FOXHOTFIELD/Task3_YawPID_STM32F103C8/docs/tuning/drive_pulse300_2s.csv

t_s | target_deg | yaw_deg
3.7383 | -135.307 | 72.593
3.7383 | -135.307 | 72.577
3.7384 | -135.307 | 72.025
3.7384 | -135.307 | 71.085
3.7384 | -135.307 | 70.214
3.7384 | -135.307 | 69.104
3.7384 | -135.307 | 67.849
3.7384 | -135.307 | 66.563
3.7384 | -135.307 | 65.266
3.7384 | -135.307 | 64.167
3.7384 | -135.307 | 63.066
3.7384 | -135.307 | 61.726
3.7384 | -135.307 | 60.278
3.7384 | -135.307 | 58.985
3.7384 | -135.307 | 57.627
3.7384 | -135.307 | 56.229
3.7384 | -135.307 | 54.916
3.7384 | -135.307 | 53.760
3.7384 | -135.307 | 52.487
3.7384 | -135.307 | 51.037
3.7384 | -135.307 | 49.668
3.7384 | -135.307 | 48.425
3.7384 | -135.307 | 47.100
3.7384 | -135.307 | 45.792
3.7384 | -135.307 | 44.555
3.7384 | -135.307 | 43.479
3.7384 | -135.307 | 42.160
3.7384 | -135.307 | 40.780
3.7384 | -135.307 | 39.487
3.7384 | -135.307 | 38.288
3.7384 | -135.307 | 37.017
3.7384 | -135.307 | 35.746
3.7384 | -135.307 | 34.578
3.7384 | -135.307 | 33.544
3.7384 | -135.307 | 32.387
3.7384 | -135.307 | 31.054
3.7384 | -135.307 | 29.805
3.7384 | -135.307 | 28.612
3.7384 | -135.307 | 27.424
3.7385 | -135.307 | 26.187
3.7385 | -135.307 | 25.018
3.7385 | -135.307 | 23.957
3.7385 | -135.307 | 23.024
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
