FOXHOTFIELD/Task3_YawPID_STM32F103C8/docs/tuning/hands_hold.csv

t_s | target_deg | yaw_deg | rate_dps
0.0120 | 0.000 | 0.570 | -0.10
0.0199 | 0.000 | 0.570 | 0.07
0.0316 | 0.000 | 0.570 | -0.06
0.0415 | 0.000 | 0.570 | 0.02
0.0513 | 0.000 | 0.569 | 0.02
0.0608 | 0.000 | 0.569 | -0.06
0.0709 | 0.000 | 0.570 | 0.02
0.0801 | 0.000 | 0.569 | -0.10
0.0903 | 0.000 | 0.569 | 0.04
0.1004 | 0.000 | 0.568 | -0.06
0.1106 | 0.000 | 0.568 | -0.06
0.1201 | 0.000 | 0.568 | -0.09
0.1301 | 0.000 | 0.568 | 0.01
0.1401 | 0.000 | 0.568 | 0.04
0.1501 | 0.000 | 0.568 | -0.06
0.1623 | 0.000 | 0.567 | -0.03
0.1700 | 0.000 | 0.567 | 0.01
0.1820 | 0.000 | 0.567 | -0.01
0.1919 | 0.000 | 0.567 | -0.04
0.2017 | 0.000 | 0.567 | 0.05
0.2101 | 0.000 | 0.567 | -0.12
0.2200 | 0.000 | 0.568 | 0.04
0.2316 | 0.000 | 0.567 | -0.04
0.2411 | 0.000 | 0.567 | -0.04
0.2504 | 0.000 | 0.567 | -0.01
0.2599 | 0.000 | 0.566 | 0.01
0.2720 | 0.000 | 0.566 | -0.06
0.2823 | 0.000 | 0.566 | 0.02
0.2901 | 0.000 | 0.567 | 0.07
0.3004 | 0.000 | 0.567 | 0.04
0.3102 | 0.000 | 0.566 | -0.06
0.3205 | 0.000 | 0.566 | -0.09
0.3306 | 0.000 | 0.565 | -0.13
0.3407 | 0.000 | 0.565 | 0.01
0.3504 | 0.000 | 0.565 | -0.09
0.3619 | 0.000 | 0.563 | -0.15
0.3720 | 0.000 | 0.562 | -0.10
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
