FOXHOTFIELD/Task3_YawPID_STM32F103C8/docs/tuning/hands_push.csv

t_s | target_deg | yaw_deg | rate_dps
0.0101 | 0.000 | -3.399 | -24.28
0.0199 | 0.000 | -3.641 | -24.71
0.0315 | 0.000 | -3.849 | -20.92
0.0416 | 0.000 | -4.084 | -21.94
0.0511 | 0.000 | -4.216 | -11.15
0.0613 | 0.000 | -4.308 | -9.11
0.0708 | 0.000 | -4.386 | -7.32
0.0805 | 0.000 | -4.466 | -8.75
0.0903 | 0.000 | -4.581 | -12.06
0.1000 | 0.000 | -4.646 | -4.35
0.1100 | 0.000 | -4.692 | -4.85
0.1222 | 0.000 | -4.749 | -6.63
0.1310 | 0.000 | -4.801 | -4.26
0.1404 | 0.000 | -4.851 | -5.48
0.1505 | 0.000 | -4.912 | -6.13
0.1604 | 0.000 | -4.981 | -7.33
0.1705 | 0.000 | -5.061 | -8.09
0.1803 | 0.000 | -5.139 | -7.55
0.1920 | 0.000 | -5.212 | -7.35
0.2022 | 0.000 | -5.329 | -12.68
0.2122 | 0.000 | -5.415 | -7.71
0.2201 | 0.000 | -5.501 | -9.46
0.2305 | 0.000 | -5.606 | -10.53
0.2402 | 0.000 | -5.712 | -10.79
0.2519 | 0.000 | -5.834 | -12.82
0.2621 | 0.000 | -5.963 | -12.61
0.2716 | 0.000 | -6.083 | -11.70
0.2811 | 0.000 | -6.183 | -9.47
0.2917 | 0.000 | -6.270 | -8.72
0.3007 | 0.000 | -6.359 | -8.77
0.3105 | 0.000 | -6.450 | -9.41
0.3208 | 0.000 | -6.554 | -10.75
0.3309 | 0.000 | -6.672 | -12.22
0.3409 | 0.000 | -6.804 | -13.33
0.3503 | 0.000 | -6.941 | -13.85
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
