FOXHOTFIELD/Task3_YawPID_STM32F103C8/docs/tuning/imu_p_test.csv

t_s | target_deg | yaw_deg
4.4794 | 15.000 | 11.167
4.4794 | 15.000 | 11.093
4.4794 | 15.000 | 11.020
4.4794 | 15.000 | 10.947
4.4794 | 15.000 | 10.875
4.4794 | 15.000 | 10.804
4.4794 | 15.000 | 10.731
4.4794 | 15.000 | 10.659
4.4794 | 15.000 | 10.586
4.4794 | 15.000 | 10.513
4.4794 | 15.000 | 10.439
4.4794 | 15.000 | 10.365
4.4794 | 15.000 | 10.290
4.4794 | 15.000 | 10.216
4.4794 | 15.000 | 10.142
4.4794 | 15.000 | 10.068
4.4794 | 15.000 | 9.994
4.4794 | 15.000 | 9.919
4.4794 | 15.000 | 9.844
4.4794 | 15.000 | 9.770
4.4794 | 15.000 | 9.697
4.4794 | 15.000 | 9.623
4.4794 | 15.000 | 9.548
4.4794 | 15.000 | 9.474
4.4794 | 15.000 | 9.400
4.4794 | 15.000 | 9.326
4.4795 | 15.000 | 9.252
4.4795 | 15.000 | 9.177
4.4795 | 15.000 | 9.103
4.4795 | 15.000 | 9.029
4.4795 | 15.000 | 8.955
4.4795 | 15.000 | 8.881
4.4795 | 15.000 | 8.806
4.4795 | 15.000 | 8.731
4.4795 | 15.000 | 8.657
4.4795 | 15.000 | 8.583
4.4795 | 15.000 | 8.509
4.4795 | 15.000 | 8.434
4.4795 | 15.000 | 8.359
4.4795 | 15.000 | 8.284
4.4795 | 15.000 | 8.210
4.4795 | 15.000 | 8.136
4.4795 | 15.000 | 8.061
4.4795 | 15.000 | 7.988
4.4795 | 15.000 | 7.914
4.4795 | 15.000 | 7.841
4.4795 | 15.000 | 7.767
4.4795 | 15.000 | 7.693
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
