FOXHOTFIELD/Task3_YawPID_STM32F103C8/docs/tuning/openloop_duty100.csv

t_s | target_deg | yaw_deg
4.5097 | 0.001 | 0.668
4.5097 | 0.001 | 0.668
4.5097 | 0.001 | 0.668
4.5097 | 0.001 | 0.668
4.5097 | 0.001 | 0.668
4.5097 | 0.001 | 0.668
4.5097 | 0.001 | 0.668
4.5097 | 0.001 | 0.668
4.5097 | 0.001 | 0.668
4.5097 | 0.001 | 0.668
4.5097 | 0.001 | 0.668
4.5097 | 0.001 | 0.668
4.5097 | 0.001 | 0.668
4.5097 | 0.001 | 0.668
4.5097 | 0.001 | 0.668
4.5097 | 0.001 | 0.668
4.5097 | 0.001 | 0.668
4.5097 | 0.001 | 0.668
4.5097 | 0.001 | 0.668
4.5097 | 0.001 | 0.668
4.5097 | 0.001 | 0.668
4.5097 | 0.001 | 0.668
4.5097 | 0.001 | 0.668
4.5097 | 0.001 | 0.668
4.5097 | 0.001 | 0.668
4.5098 | 0.001 | 0.668
4.5098 | 0.001 | 0.668
4.5098 | 0.001 | 0.668
4.5098 | 0.001 | 0.668
4.5098 | 0.001 | 0.668
4.5098 | 0.001 | 0.668
4.5098 | 0.001 | 0.668
4.5098 | 0.001 | 0.668
4.5098 | 0.001 | 0.668
4.5098 | 0.001 | 0.668
4.5098 | 0.001 | 0.668
4.5098 | 0.001 | 0.668
4.5098 | 0.001 | 0.668
4.5098 | 0.001 | 0.668
4.5098 | 0.001 | 0.668
4.5098 | 0.001 | 0.668
4.5098 | 0.001 | 0.668
4.5098 | 0.001 | 0.668
4.5098 | 0.001 | 0.668
4.5098 | 0.001 | 0.668
4.5098 | 0.001 | 0.668
4.5098 | 0.001 | 0.668
4.5098 | 0.001 | 0.668
4.5098 | 0.001 | 0.668
4.5098 | 0.001 | 0.668
4.5098 | 0.001 | 0.668
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
