FOXHOTFIELD/Task3_YawPID_STM32F103C8/docs/tuning/openloop_duty200.csv

t_s | target_deg | yaw_deg
4.3097 | -0.004 | 0.000
4.3097 | -0.004 | 0.000
4.3097 | -0.004 | 0.000
4.3097 | -0.004 | 0.000
4.3097 | -0.004 | 0.000
4.3097 | -0.004 | 0.000
4.3097 | -0.004 | 0.000
4.3097 | -0.004 | 0.000
4.3097 | -0.004 | 0.000
4.3097 | -0.004 | 0.000
4.3097 | -0.004 | 0.000
4.3097 | -0.004 | 0.000
4.3097 | -0.004 | 0.000
4.3097 | -0.004 | 0.000
4.3097 | -0.004 | 0.000
4.3097 | -0.004 | 0.000
4.3097 | -0.004 | 0.000
4.3097 | -0.004 | 0.000
4.3097 | -0.004 | 0.000
4.3097 | -0.004 | 0.000
4.3097 | -0.004 | 0.000
4.3097 | -0.004 | 0.000
4.3097 | -0.004 | 0.000
4.3097 | -0.004 | 0.000
4.3097 | -0.004 | 0.000
4.3097 | -0.004 | 0.000
4.3097 | -0.004 | 0.000
4.3097 | -0.004 | 0.000
4.3097 | -0.004 | 0.000
4.3097 | -0.004 | 0.000
4.3097 | -0.004 | 0.000
4.3097 | -0.004 | 0.000
4.3097 | -0.004 | 0.000
4.3097 | -0.004 | 0.000
4.3097 | -0.004 | 0.000
4.3097 | -0.004 | 0.000
4.3097 | -0.004 | 0.000
4.3097 | -0.004 | 0.000
4.3097 | -0.004 | 0.000
4.3097 | -0.004 | 0.000
4.3097 | -0.004 | 0.000
4.3097 | -0.004 | 0.000
4.3097 | -0.004 | 0.000
4.3097 | -0.004 | 0.000
4.3097 | -0.004 | 0.000
4.3097 | -0.004 | 0.000
4.3097 | -0.004 | 0.000
4.3097 | -0.004 | 0.000
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
