FOXHOTFIELD/Task3_YawPID_STM32F103C8/Core/Inc/main.h

/**
 * @file    main.h
 * @brief   26级第三期考核任务 —— TB6612 电机驱动与水平转盘 Yaw 闭环控制
 * @target  STM32F103C8T6 最小系统板, HSE 8MHz, SYSCLK 72MHz
 */
#ifndef __MAIN_H
#define __MAIN_H

#ifdef __cplusplus
extern "C" {
#endif

#include "stm32f1xx_hal.h"

void Error_Handler(void);

#ifdef __cplusplus
}
#endif

#endif /* __MAIN_H */
