FOXHOTFIELD/Task3_YawPID_STM32F103C8/App/Inc/app_i2c_bus.h

/**
 * @file    app_i2c_bus.h
 * @brief   I2C 总线抽象：硬件 I2C 与软件模拟 I2C 两套实现，接口一致
 *
 * 评分点 2 要求"理解硬件 I2C 与软件模拟 I2C 的区别"，
 * 所以这里把两者做成同一套 API 的两个后端，由 board_config.h 里的
 * IMU_I2C_BACKEND_HW 编译期切换：
 *   - 硬件 I2C：由 I2C1 外设产生严格的起始/停止/ACK 时序，CPU 不参与位操作，
 *               可以挂 DMA，速率可到 400kHz 且抖动小；
 *   - 软件模拟：GPIO 开漏 + 延时函数自己翻电平，时序受中断影响会抖动，
 *               速率受 CPU 主频和延时精度限制，但引脚可任意指定、不占用外设。
 */
#ifndef APP_I2C_BUS_H
#define APP_I2C_BUS_H

#ifdef __cplusplus
extern "C" {
#endif

#include <stdint.h>
#include "stm32f1xx_hal.h"

/** @brief 初始化所选后端（软件后端会重新配置 PB6/PB7 为开漏 GPIO） */
HAL_StatusTypeDef i2c_bus_init(void);

/** @brief 写寄存器（单寄存器地址 + n 字节数据） */
HAL_StatusTypeDef i2c_bus_write(uint8_t addr7, uint8_t reg, const uint8_t *data, uint16_t len);

/** @brief 读寄存器（单寄存器地址 + n 字节数据），轮询式 */
HAL_StatusTypeDef i2c_bus_read(uint8_t addr7, uint8_t reg, uint8_t *data, uint16_t len);

/** @brief 读寄存器（DMA 方式，仅硬件后端支持；软件后端返回 HAL_ERROR） */
HAL_StatusTypeDef i2c_bus_read_dma(uint8_t addr7, uint8_t reg, uint8_t *data, uint16_t len);

/** @brief 总线卡死后的恢复：SCL 打 9 个时钟 + 发送 STOP */
void i2c_bus_recover(void);

/** @brief 后端名称，用于 INFO/日志输出 */
const char *i2c_bus_name(void);

/**
 * @brief 扫描 0x08..0x77 上应答的地址
 * @param found 输出数组
 * @param max   数组容量
 * @return 实际找到的设备数
 */
uint8_t i2c_bus_scan(uint8_t *found, uint8_t max);

#ifdef __cplusplus
}
#endif

#endif /* APP_I2C_BUS_H */
