FOXHOTFIELD/Task3_YawPID_STM32F103C8/(commit log)

2026-10-24 feat: 初始化 Task3 转盘偏航闭环工程（v1.1.2 编码器反馈整定完成）
    [drive_pulse300_2s.csv, openloop_duty100.csv, openloop_duty200.csv, step_kp2.5_ki0.3_kd3_t0.csv, step_kp2_ki0.5_kd1_t20.csv, step_ramp_10.csv, step_ramp_dz200.csv, tune_kp2_kd7_dz250.csv]
2026-10-24 feat: 真机整定 v1.1.4（制动增强非对称出力）+ 任务书全项验收 17 项通过
2026-10-31 feat: v1.2.4 陀螺反馈接入与粘滑极限环修复
    - CPD 修正：13.6 -> 6.933（13 线 x4 x48:1 = 2496 counts/rev），此前所有角度差 2 倍
    - 新增 GSIG=+-1 安装方向补偿（本机芯片面朝下，Z 轴向下，取 -1）
    - 零偏在线学习加双闸（编码器静止 500ms + 变化限幅 +-4dps），修复自学习把真实转动学成零偏
    - 修复 ctl_manual 限位守卫方向反了（用 ctl_enc_dir 取真实运动方向）
    - 陀螺反馈的控制用角速度再低通 80ms（CTL_RATE_TAU_IMU_MS），Kd 与制动增强改用滤波后的 rate
    - 制动增强门限按反馈源区分：编码器 20dps，陀螺 60dps（陀螺原始 rate 有 +-400dps 粘滑冲击）
    - 新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
    [step_imu_kp30_ki1.5_kd2_t-30.csv, step_imu_kp30_ki1.5_kd2_t30.csv]
2026-10-31 feat: v1.2.5 反馈源切换时自动套用对应增益组
    实测发现陀螺闭环不能沿用编码器的整定值：
    - 编码器在电机轴上，几乎无滞后，适合高带宽（30/1.5/2）；
    - 陀螺闭环套的是转盘，中间隔着弹性传动和约 5 度回程间隙，高带宽会把
    弹性传动激成 5Hz 极限环（实测超调 10 度、抖动 5.8 度、500/599 帧角速度超 200dps）。
    改成 Kp=12/Ki=1.5/Kd=0 之后，同一条「大位移后立刻反向」序列反而全面更好：
    超调 1.59 度、上升 0.171s、稳定 0.222s、静差 -0.031 度、抖动 0.002 度。
    三种序列复验均稳定：-30 度、+80 度大位移、+80 度后反向 -30 度。
    机械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
    [step_enc_kp30_ki4_kd2_t-30.csv, step_fuse_kp12_ki1.5_kd0_t-30.csv, step_fuse_kp12_ki1.5_kd0_t30.csv, step_imu_kp12_ki1.5_kd0_t-30.csv, step_imu_kp12_ki1.5_kd0_t30.csv, step_imu_kp12_ki1.5_kd0_t80.csv, step_imu_kp30_ki4_kd2_t-90.csv]
2026-10-31 feat: v1.2.6 IMU 增益终定 12/0.8/0，扰动恢复与定位误差达标
    按任务书发挥部分逐条实测（FB=IMU，Kp=12/Ki=0.8/Kd=0）：
    - 定位误差：+30 度静差 0.131 度、-30 度静差 -0.130 度（判据 +-1.5 度）；
    - 扰动恢复：开环脉冲拨开 37~38 度后松手，回位超调 0.394~0.494 度、
    稳定 0.23~0.24s、最终静差 0.045~0.153 度（判据：无超调 + 静差 1.5 度）；
    - 阶跃：+30 度超调 1.23 度/上升 0.162s，-30 度超调 0.25 度/上升 0.180s。
    调参过程记录（同一扰动恢复测试）：
    Ki=1.5 Kd=0 -> 回位超调 0.992 度（不达标）
    Ki=1.5 Kd=1 -> 超调 0 但阶跃拖慢（上升 0.372s、稳定 3.611s、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
    [recover_imu_kp12_ki0.8_kd0_d30.csv, recover_imu_kp12_ki1.5_kd0_d30.csv, recover_imu_kp12_ki1.5_kd1_d30.csv, step_imu_kp12_ki0.8_kd0_t-30.csv, step_imu_kp12_ki0.8_kd0_t30.csv]
2026-10-31 test: 60 秒长时锁定与 +-180 最短路径验证
    - 60 秒锁定（FB=IMU，Kp=12/Ki=0.8/Kd=0，目标 0 度）：
    静态误差 -0.059 度、抖动 0.004 度、角速度峰值 0.2dps、
    6000 帧无一帧超过 200dps。判据 +-2.5 度，余量很大。
    - +-180 最短路径：用 STAT 的 err 字段验证环绕算法（无需真的转 340 度）。
    转盘在 +20.169 度时发 SET=-179，固件回 err=+160.83 度
    （= wrap(-179 - 20.169)），朴素实现会给 -199.17 度，说明走了短边；
    SET=+179 时 err=+158.86 度，同样正确。
    任务书例子 +170 到 -170 只转 20 度符合同一逻辑。
    受排线 +-150 度限制，未做 340 度实转演示。
    [step_imu_kp12_ki0.8_kd0_t0.csv]
2026-10-31 feat: v1.2.7 切换反馈源时同时自动开关 ZUPT
    ZUPT 在判静止期间把积分 dt 置 0。陀螺闭环下这是有害的：慢速转动时编码器
    很多拍是 0 增量、角速度又低于 1dps 门限，会被整段误判成静止，
    实测一次手转只积到真实转角的 72%（97.5 度只积到 96.6/134 度级别）。
    而 60 秒锁定实测表明关掉 ZUPT 照样能把静态误差压在 -0.059 度，
    所以 FB=IMU/FUSE 时默认关 ZUPT，FB=ENC 时按原默认开。
    切换日志同时打印增益与 zupt 状态，便于串口侧确认。
2026-10-31 feat: v1.2.8 静态顶住增强（被手按住时也能给满出力）
    问题：原来的出力增强只在 |rate| > 门限 时生效，手慢慢按住转盘时速度只有
    5~20dps，触发不了；此时出力被 OMAX 卡在 300pm（40% 占空比），误差超过约
    25 度后不再增长，所以手感是"越推越轻"。松手后速度一上来，增强立刻接管，
    实测 55 度回位只要 0.42s（瞬时 270dps），说明回正力本身是足的。
    新增判据（三条同时满足才触发）：
    |误差| > 10 度 被推离目标
    |速度| < 25dps 几乎不动（被按住，而不是自己在加速）
    持续 500ms 给正常起步留 5 倍余量
    触发后出力同样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
    [app_ctl.c, board_config.h]
2026-10-31 test: v1.2.8 回归数据 + 人手推/按实录
    v1.2.8 回归（新增的静态顶住增强未改变已验收行为）：
    - 阶跃 +30 度：上升 0.18~0.19s、超调 2.28~3.18 度、静差 0.17~0.43 度；
    -30 度：上升 0.20s、超调 0.30~0.55 度、静差 0.21~0.29 度；
    正方向本身就处在临界阻尼附近（波形是"冲过头-刹回-再冲"两个半周期），
    与本次改动无关：若增强触发，出力会从 40% 跳到 100%，上升时间应明显变短，实测没变。
    - 拨开回位：拨 44.6~45.4 度，超调 0.55~0.80 度、稳定 0.26s，与 v1.2.6/1.2.7 同水平。
    hands_push.csv / hands_hold.csv：人手拨开+按住实录。
    关键数据：手推过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
    [hands_hold.csv, hands_push.csv, recover_imu_kp12_ki0.8_kd0_d35.csv, step_imu_kp12_ki0.8_kd0_t-30.csv, step_imu_kp12_ki0.8_kd0_t0.csv, step_imu_kp12_ki0.8_kd0_t30.csv]
2026-10-31 docs: 更新 README 与实现说明，上位机工具并入仓库
    README 重写（原内容停在 v1.1.4/编码器时期，且写着"IMU 不在机上"）：
    - 版本与体积更新到 v1.2.8 实测（Code 30628 B / HEX 89450 B）；
    - CPD 改为真值 6.933（13 线 x4 x48:1 = 2496 counts/rev），并说明旧的 13.6 恰是 2 倍；
    - 新增 4.11 回程间隙约 5 度（含"换向 +5.58 度 / 同向 +0.66 度"实测表，以及
    FB=ENC 换向后转盘实际少转 3.6 度而编码器显示 0.000 度抖动）；
    - 新增 4.12 弹性传动引起的 5Hz 极限环（400dps 粘滑冲击 -> Kd 与制动增强被打满）；
    - 4.1 补"按反馈源自动套用增益与 ZUPT"的对照表；4.5 补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
2026-10-31 docs: 修正 README 中 JustFloat 帧尾写法（00 00 80 7F）
2026-10-31 fix: v1.3.0 大角度转动死锁修复（路径选择）与 +-90 度行程
    根因（用户 Vofa 截图：实际 +160 度、目标 -30 度、电机完全不出力）：
    s_error 取最短路径 wrap(-30 - 160) = +170，要求继续往正方向转 170 度；
    而软限位守卫在 |角度| > 限位-余量 时只放行"往回收"的出力，于是把
    正方向出力清零 —— 误差明明 170 度却零出力，转盘永远不动。
    修复：
    - 新增 ctl_route_error()：默认取最短路径，若其终点超出 +-限位，就改走
    另一条（本例从 +160 到 -30 改走 -190 度，经 0 过去）。起点终点都在限位
    内时，单调走法必然不越界，所以只判终点即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
    [app_ctl.c, board_config.h]
2026-11-01 refactor: tune_yaw 串口读取改为非阻塞，并提交本轮测试数据
    tune_yaw.py 的 Link 原来用 read(4096) + timeout=0.05：在 Windows 上
    timeout 是"字符间隔超时"，100Hz 遥测流每 10ms 就有一个字节，永远凑不满
    这个间隔，于是 read(N) 会阻塞到攒够 N 字节（实测 read(4096) 要 2.4s）。
    改成 timeout=0 + 先看 in_waiting 再读，同一条命令从秒级降到 0.05s 量级；
    计时改用 perf_counter。
    同时入库本轮 v1.2.x ~ v1.3.0 的阶跃/回位测试 CSV（含 +-90 全行程与
    KP/KI/KD 对比数据），作为调参过程的可复现记录。
    [imu_p_test.csv, recover_imu_kp12_ki0.5_kd0_d30.csv, recover_imu_kp12_ki1.5_kd2_d30.csv, step_imu_kp12_ki0.8_kd0_t-90.csv, step_imu_kp12_ki0.8_kd0_t90.csv, step_imu_kp12_ki1.5_kd0_t-120.csv, step_imu_kp12_ki1.5_kd1_t-30.csv, step_imu_kp12_ki1.5_kd1_t30.csv]
